cstanley1/411-Project-Plant-Monitor/README.md

# 411 Project: Happy Plant

Happy Plant is designed to help keep track of a plant’s health. Simply plant your plant in the Happy Plant Planter, and the light-up display will tell you when it's time to water!
