cstanley1/411-Project-Plant-Monitor/Project Files/Decision Matrix for LED dispaly.pdf

### Decision Matrix

LED Display | 7-Segment | Emoji miniature | 32 x 32 Dot Matrix
Cost | $14.95 | $11.95 | $39.95
Supply Voltage | 5V | 3V (yellow) | 5V
Supply Current | 20mA | 120mA | 2 − 4Amps
Battery life | good | good | ok
Display Capacity | 20cℎars x 2lines | 1 digit | ~15 cℎars
Special Character display | yes | no | yes
require programing | yes | yes | yes
Software support | Arduino, Raspberry pi | Arduino | Arduino, Raspberry pi
size | medium | small | large
Complexity of programing | easy | easy | medium
