cstanley1/411-Project-Plant-Monitor/Hardware/Schematic.png

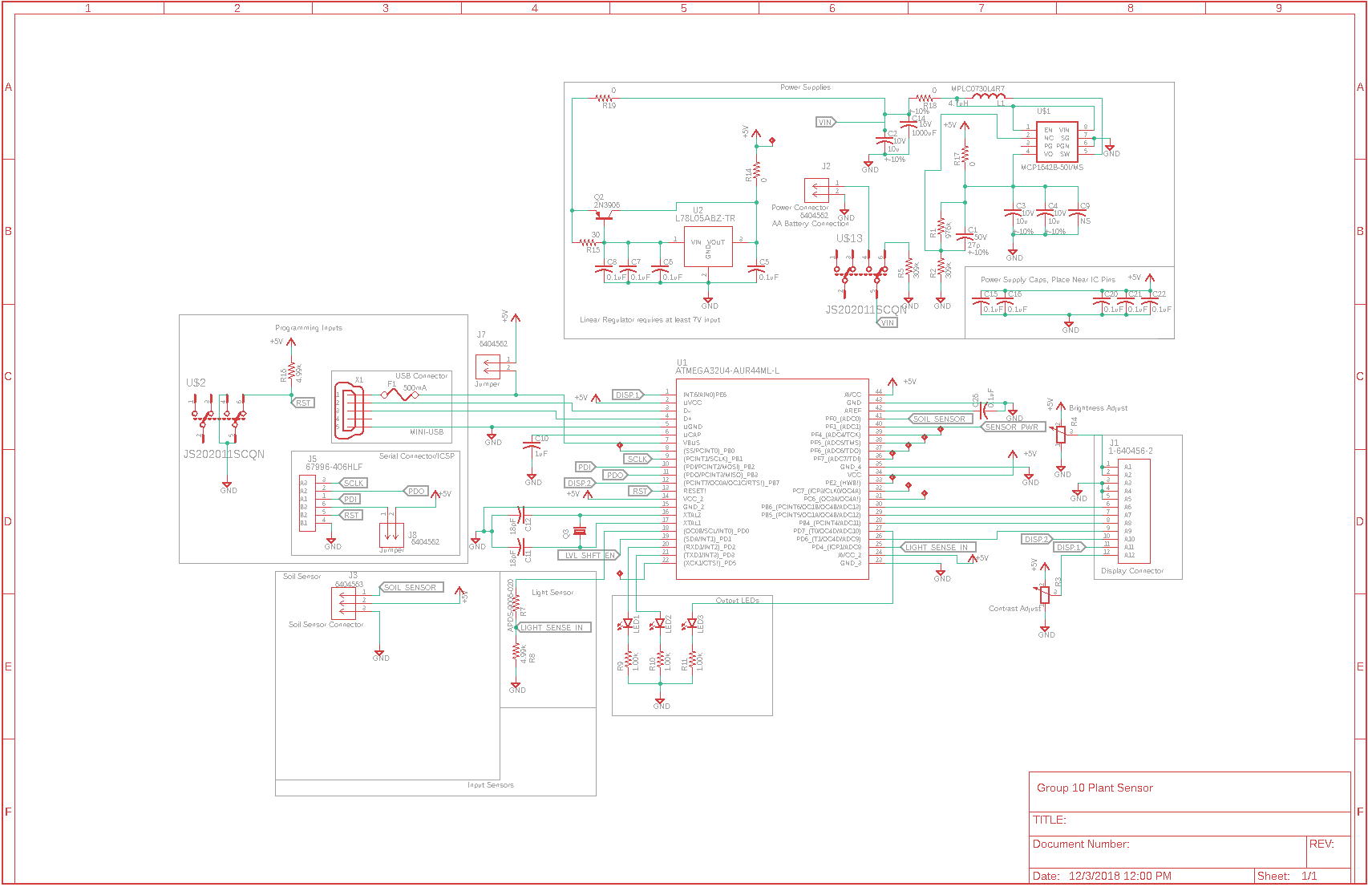
Hardware/Schematic.png
