cstanley1/411-Project-Plant-Monitor/Hardware/Group 10 Plant Sensor.brd

## EAGLE design Hardware/Group 10 Plant Sensor.brd (2018-12-03)

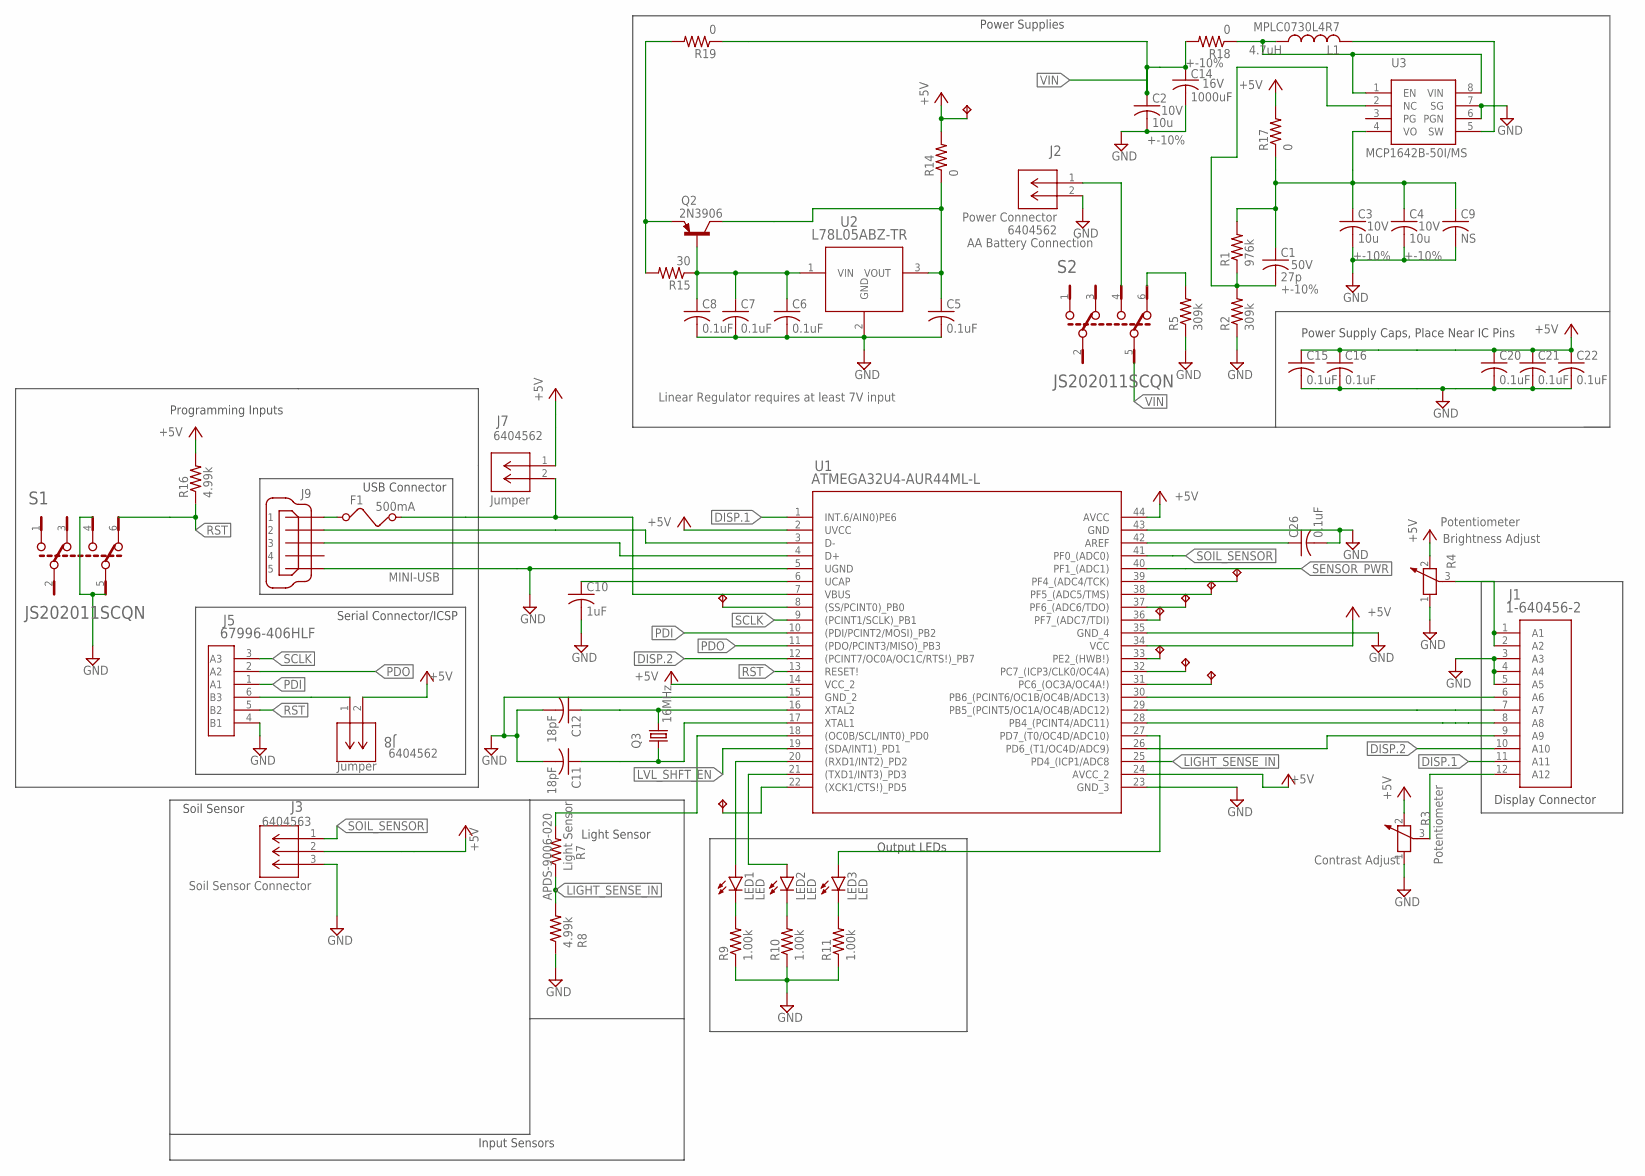
[picture p7: schematic Group 10 Plant Sensor.sch]

Parts:
C1: 27p; C0805K; VOLTAGE 50V; MFG_PART_NUMBER C0805C270J1GACTU
C2, C3, C4: 10u; C0805K; VOLTAGE 10V; MFG_PART_NUMBER GRM21BR61D106ME15L
C5, C6, C7, C8, C15, C16, C20, C21, C22, C26: 0.1uF; C0805; MFG_PART_NUMBER C0805C104K6RACTU
C9: NS; C0603K
C10: 1uF; C0805K; MFG_PART_NUMBER LMK212BJ105KD-T
C11, C12: 18pF; C0805K; MFG_PART_NUMBER GRM21A5C2E180JW01D
C14: 1000uF; C050-050X075; VOLTAGE 16V; MFG_PART_NUMBER EEU-FS1A102B
F1: 500mA; R1206; MFG_PART_NUMBER CC12H500MA-TR
J1: 1-640456-2; MFG_PART_NUMBER 1-640456-2
J2, J7, J8: 640456-2; CONN2_640456-2; MFG_PART_NUMBER 640456-2
J3: 640456-3; CONN3_640456-3; MFG_PART_NUMBER 640456-3
J5: 67996-406HLF; MFG_PART_NUMBER 67996-406HLF
J9: MINI-USB; 32005-201; MFG_PART_NUMBER UJ2-MABH-2-SMT-TR
L1: MPLC0730L4R7; MFG_PART_NUMBER NPIM74C4R7MTRF
LED1, LED2, LED3: LED; LED3MM; MFG_PART_NUMBER WP7113SRD/J4
Q2: 2N3906; TO92; MFG_PART_NUMBER 2N3906
Q3: 16MHz; HC18U-V; MFG_PART_NUMBER FC4STCBAF16.0-BAG200
R1: 976k; R0805; MFG_PART_NUMBER ERA-6AEB9763V
R2, R5: 309k; R0805; MFG_PART_NUMBER ERA-6AEB3093V
R3, R4: Potentiometer; PT-10S; MFG_PART_NUMBER PT10LH01-102A2020
R7: Light Sensor; R1206W; MFG_PART_NUMBER APDS-9006-020
R8, R16: 4.99k; R1206W; MFG_PART_NUMBER ERJ-PB6B4991V
R9, R10, R11: 1.00k; R0805; MFG_PART_NUMBER CRGH0805J1K0
R14, R17, R18, R19: 0; R0603; MFG_PART_NUMBER CRCW08050000Z0EBC
R15: 30; R0805; MFG_PART_NUMBER ERA-6AEB3093V
S1, S2: SWITCH2; C&K_JS202011CQN_0; MFG_PART_NUMBER JS202011SCQN
U1: ATMEGA32U4-AUR44ML-L; 44ML-L; MFG_PART_NUMBER ATMEGA32U4-AUR
U2: L78L05ABZ-TR; TO-92-TR; MFG_PART_NUMBER L78L05ABZ
U3: MCP1642B/D8-MSOP; MSOP8; MFG_PART_NUMBER MCP1642B-50I/MS
U$3, U$4, U$5, U$6, U$7, U$8, U$9, U$10, U$11, U$12: TESTPIN; 1-640456-0(2)

Connections:
AREF: C26.1, U1.42 (AREF)
DISP.1: J1.11 (A11), U1.1 (INT.6/AIN0)PE6)
DISP.2: J1.10 (A10), U1.12 ((PCINT7/OC0A/OC1C/RTS!)_PB7)
DISP_5: J1.8 (A8), U1.28 (PB4_(PCINT4/ADC11))
GND: C2.2, C3.2, C4.2, C5.2, C6.2, C7.2, C8.2, C9.2, C10.2, C11.2, C12.2, C14.2, C15.2, C16.2, C20.2, C21.2, C22.2, C26.2, J1.3 (A3), J1.4 (A4), J1.5 (A5), J2.2, J3.3, J5.4 (B1), J9.5, R2.1, R3.1, R4.1, R5.1, R8.1, R9.1, R10.1, R11.1, S1.4, S1.5, U1.5 (UGND), U1.15 (GND_2), U1.23 (GND_3), U1.35 (GND_4), U1.43 (GND), U2.2 (GND), U3.6 (PGN), U3.7 (SG)
LIGHT_SENSE_IN: R7.1, R8.2, U1.25 (PD4_(ICP1/ADC8)
LIGHT_SENSE_PWR: R7.2, U1.18 ((OC0B/SCL/INT0)_PD0)
LVL_SHFT_EN: U1.19 ((SDA/INT1)_PD1)
unnamed: J1.12 (A12), R3.3
unnamed: L1.2, U3.5 (SW)
unnamed: J1.9 (A9), U1.26 (PD6_(T1/OC4D/ADC9))
unnamed: C12.1, Q3.2, U1.16 (XTAL2)
unnamed: J1.6 (A6), U1.30 (PB6_(PCINT6/OC1B/OC4B/ADC13))
unnamed: J1.7 (A7), U1.29 (PB5_(PCINT5/OC1A/OC4B/ADC12))
unnamed: C11.1, Q3.1, U1.17 (XTAL1)
unnamed: J9.2, U1.3 (D-)
unnamed: J9.3, U1.4 (D+)
unnamed: F1.1, J9.1
unnamed: LED3.K (C), R11.2
unnamed: C1.1, C3.1, C4.1, C9.1, R1.2, R17.1, U3.4 (VO)
unnamed: J1.1 (A1), J1.2 (A2), R4.3
unnamed: C6.1, C7.1, C8.1, Q2.2 (B), R15.1, U2.1 (VIN)
unnamed: C10.1, U1.6 (UCAP)
unnamed: C5.1, Q2.1 (C), R14.1, U2.3 (VOUT)
unnamed: LED2.K (C), R10.2
unnamed: J5.6 (B3), J8.1
unnamed: LED1.K (C), R9.2
unnamed: U1.8 ((SS/PCINT0)_PB0), U$12.1
unnamed: R5.2, S2.6
unnamed: LED1.A, U1.20 ((RXD1/INT2)_PD2)
unnamed: LED2.A, U1.21 ((TXD1/INT3)_PD3)
unnamed: LED3.A, U1.27 (PD7_(T0/OC4D/ADC10))
unnamed: U1.31 (PC6_(OC3A/OC4A!)), U$10.1
unnamed: Q2.3 (E), R15.2, R19.2
unnamed: U1.32 (PC7_(ICP3/CLK0/OC4A)), U$9.1
unnamed: J2.1, S2.4
unnamed: U1.33 (PE2_(HWB!)), U$8.1
unnamed: U1.36 (PF7_(ADC7/TDI)), U$7.1
unnamed: U1.37 (PF6_(ADC6/TDO)), U$6.1
unnamed: U1.22 ((XCK1/CTS!)_PD5), U$11.1
unnamed: U1.38 (PF5_(ADC5/TMS)), U$5.1
unnamed: U1.39 (PF4_(ADC4/TCK)), U$4.1
PDI: J5.1 (A1), U1.10 ((PDI/PCINT2/MOSI)_PB2)
PDO: J5.2 (A2), U1.11 ((PDO/PCINT3/MISO)_PB3)
RST: J5.5 (B2), R16.1, S1.6, U1.13 (RESET!)
SCLK: J5.3 (A3), U1.9 ((PCINT1/SCLK)_PB1)
SENSOR_PWR: U1.40 (PF1_(ADC1))
SOIL_SENSOR: J3.1, U1.41 (PF0_(ADC0))
SWITCH: L1.1, R18.1, U3.1 (EN), U3.8 (VIN)
VBUS: F1.2, J7.2, U1.7 (VBUS)
VCC: C15.1, C16.1, C20.1, C21.1, C22.1, J3.2, J7.1, J8.2, R3.2, R4.2, R14.2, R16.2, R17.2, U1.2 (UVCC), U1.14 (VCC_2), U1.24 (AVCC_2), U1.34 (VCC), U1.44 (AVCC), U$3.1
VFB: C1.2, R1.1, R2.2, U3.2 (NC)
VIN: C2.1, C14.1, R18.2, R19.1, S2.5

Notes on the sheet:
Power Supplies
USB Connector
Serial Connector/ICSP
Soil Sensor
Light Sensor
Programming Inputs
Input Sensors
Output LEDs
Display Connector
Power Supply Caps, Place Near IC Pins
AA Battery Connection
Contrast Adjust
Brightness Adjust
Linear Regulator requires at least 7V input

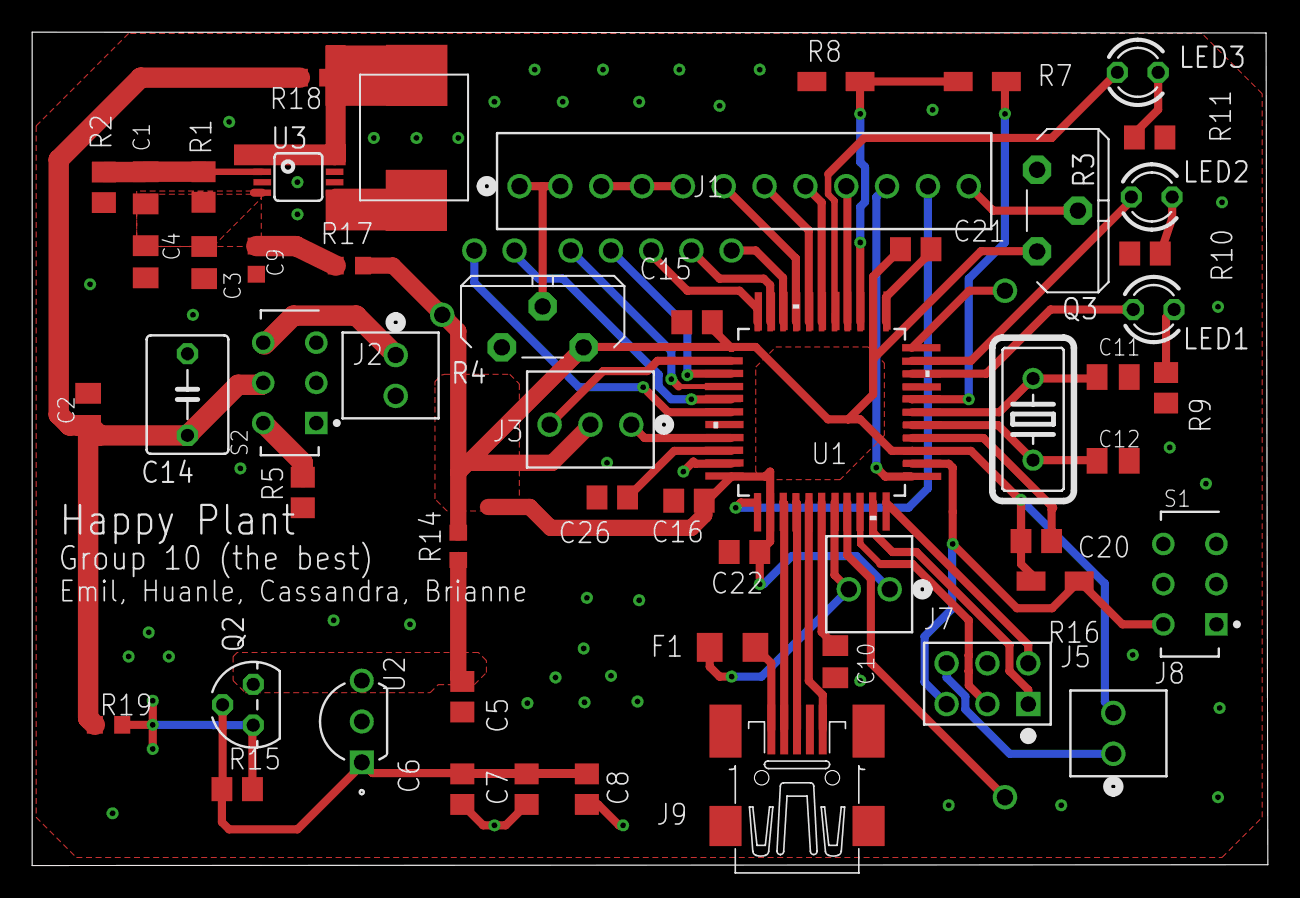
[picture p8: board Group 10 Plant Sensor.brd from above]

Board: 2 copper layers, 76.8 x 51.8 mm, 64 parts (0 on the bottom side), 51 nets.
