cstanley1/411-Project-Plant-Monitor/Software/WaterMeWSensor.ino

/*
  LiquidCrystal Library - Hello World

 Demonstrates the use a 16x2 LCD display.  The LiquidCrystal
 library works with all LCD displays that are compatible with the
 Hitachi HD44780 driver. There are many of them out there, and you
 can usually tell them by the 16-pin interface.

 This sketch prints "Hello World!" to the LCD
 and shows the time.

  The circuit:
 * LCD RS pin to digital pin 12
 * LCD Enable pin to digital pin 11
 * LCD D4 pin to digital pin 5
 * LCD D5 pin to digital pin 4
 * LCD D6 pin to digital pin 3
 * LCD D7 pin to digital pin 2
 * LCD R/W pin to ground
 * LCD VSS pin to ground
 * LCD VCC pin to 5V
 * 10K resistor:
 * ends to +5V and ground
 * wiper to LCD VO pin (pin 3)

 Library originally added 18 Apr 2008
 by David A. Mellis
 library modified 5 Jul 2009
 by Limor Fried (http://www.ladyada.net)
 example added 9 Jul 2009
 by Tom Igoe
 modified 22 Nov 2010
 by Tom Igoe
 modified 7 Nov 2016
 by Arturo Guadalupi

 This example code is in the public domain.

 http://www.arduino.cc/en/Tutorial/LiquidCrystalHelloWorld

*/

// include the library code:
#include <LiquidCrystal.h>
int val = 0; //value for storing moisture value 
int soilPin = A5;//Declare a variable for the soil moisture sensor 
int soilPower = A4;//Variable for Soil moisture Power
// initialize the library by associating any needed LCD interface pin
// with the arduino pin number it is connected to
const int rs = 7, en = 8, d4 = 9, d5 = 10, d6 = 11, d7 = 12;
LiquidCrystal lcd(7, 8, 9, 10, 11, 12);

void setup() {
  Serial.begin(9600);   // open serial over USB
  pinMode(soilPower, OUTPUT);//Set D7 as an OUTPUT
  digitalWrite(soilPower, LOW);//Set to LOW so no power is flowing through the sensor
  // set up the LCD's number of columns and rows:
}

void loop() {
  lcd.begin(16, 2);
  // Print a message to the LCD.
  lcd.print("Water");
  
Serial.print("Soil Moisture = ");    
//get soil moisture value from the function below and print it
int MoistureLevel = readSoil();     // both are correct
Serial.println(MoistureLevel);
  lcd.begin(16, 2);
if(MoistureLevel < 800)
  lcd.print("Please water me :(");
else                       //
  lcd.print(":)");

delay(1000);//take a reading every second
}
int readSoil()
{

    digitalWrite(soilPower, HIGH);//turn D7 "On"
    delay(10);//wait 10 milliseconds 
    val = analogRead(soilPin);//Read the SIG value form sensor 
    digitalWrite(soilPower, LOW);//turn D7 "Off"
    return val;//send current moisture value
}
