cstanley1/411-Project-Plant-Monitor/(commit log)

2018-10-14 Schematic Rough Draft
    the board has circuits to support: a soil moisture sensor, a DIY soil sensor, 3 LEDs, an ambient light sensor, a display, USB connectivity, and audio output (rough). The board allows programming with JTAG, a serial connection, or USB. I chose example parts, but we can change them going forward.
2018-10-24 Updated Schematic
2018-11-01 Components list
    [411 BOM.xlsx]
2018-11-08 Create Board Layout
2018-12-03 Rename Group 10 Plant Sensor.brd to Hardware/Group 10 Plant Sensor.brd
    [Group 10 Plant Sensor.brd]
2018-12-03 moved to hardware folder
    [411 BOM.xlsx]
2018-12-03 Updated as Group 10 Plant Sensor BOM
    [411 BOM.xlsx]
2018-12-03 Updated to new new layout
    [ece411-t10-plant-final-layout.brd]
2018-12-03 updated to new new schematic
    [ece411-t10-plant-final-schematic.sch]
